HexabitzPlatform/H1FR0x-Hardware/README.md

# H1FR0x-Hardware
Hexabitz Sub-GHz RF Module Hardware Design
