HexabitzPlatform/H1FR0x-Hardware/H1FR50/Released/BOM/H1FR50.xlsx

Qty | Comment | Designator | Description | MFN | MPN | Tolerance | OCTOPART_URL | Qty
4 | PAD1 | B, C, D, R | SMD Pin 1mm x 1.6mm
5 | 100nF | C1, C6, C7, C8, C9 | CAP CER 10% X7R 0603 | KEMET | C0603C104K8RACTU | 10% | https://octopart.com/c0603c103k5ractu-kemet-133094?r=sp&s=R_iPBxLnSmGqhkU2rIMFpg
1 | 100nF | C11 | X7R SMD Chip Capacitor | Murata | GRM155R71C104KA88D | 10% | https://octopart.com/grm155r71c104ka88d-murata-196880?r=sp
2 | 1uF | C2, C17 | Cap Tant Solid SMD 2012 | Yageo | CC0805KKX7R7BB105 | 10% | https://octopart.com/cc0805kkx7r7bb105-yageo-8376555?r=sp&s=YKl1wwtkROau_X5nniH2ig
1 | 2.2uF | C18 | 0805 2.2 uF 16 V ±10% Tolerance X7R Multilayer Ceramic Chip Capacitor | Taiyo Yuden | EMK212B7225KGHT |  | https://octopart.com/emk212b7225kght-taiyo+yuden-29102998?r=sp
2 | 4.7uF | C3, C4 | Cap Tant Solid SMD 2012 | Murata | GRM21BC81E475KA12L |  | https://octopart.com/grm21bc81e475ka12l-murata-10331911?r=sp&s=RY3qZSD8T6mG6TC9CHI5qQ
1 | 10nF | C5 | CAP CER 10% X7R 0603 | KEMET | C0603C103K5RACTU |  | https://octopart.com/c0603c103k5ractu-kemet-133094?r=sp&s=R_iPBxLnSmGqhkU2rIMFpg
1 | 1nF | C16 | 0402 1000 pF 50 V ±10% Tolerance X7R Multilayer Ceramic Chip Capacitor | Murata | GRM155R71H102KA01D | 10% | https://octopart.com/grm155r71h102ka01d-murata-196021?r=sp
1 | 3.9pF | C14 | Multilayer Ceramic Capacitors MLCC - SMD/SMT 0402 3.9pF 50volts C0G +/-0.05pF | Murata | GRM1555C1H3R9WA01D |  | https://octopart.com/grm1555c1h3r9wa01d-murata-20477997?r=sp
1 | 56pF | C12 | 0402 56 pF 50 V ±5 % Tolerance C0G SMT Multilayer Ceramic Capacitor | Murata | GRM1555C1H560JA01D |  | https://octopart.com/grm1555c1h560ja01d-murata-15197568?r=sp
1 | 100pF | C10 | 0402 100pF 50V ±5 % Tolerance C0G SMT Multilayer Ceramic Capacitor | Murata | GRM1555C1H101JA01D |  | https://octopart.com/grm1555c1h101ja01d-murata-15197512?r=sp
2 | 120pF | C13, C15 | 0402 120 pF 50 V ±5% Tolerance C0G SMT Multilayer Ceramic Capacitor | Murata | GRM1555C1H121JA01D |  | https://octopart.com/grm1555c1h121ja01d-murata-196010?r=sp
1 | VLMS1300-GS08 | D1 | Red 0603 130ｰ Clear 54 mcd 2 V Surface Mount ChipLED ; | Vishay | VLMS1300-GS08 |  | https://octopart.com/vlms1300-gs08-vishay-21709201?r=sp&s=_gcP4_q8T1SC6PJQPTQ9yA
1 | ESDARF02-1BU2CK | D2 | ESDARF Series 5 V 0.2 pF Bi-Directional 1-Line ESD Protection TVS Diode - ST0201 | STMicroelectronics | ESDARF02-1BU2CK |  | https://octopart.com/esdarf02-1bu2ck-stmicroelectronics-57390019?r=sp
1 | FB-TDK_MMZ1608Y300B | FB1 | Ferrite Beads Multi-Layer 30Ohm 25% 100MHz 1.5A 50mOhm DCR 0603 | TDK | MMZ1608Y300B |  | https://octopart.com/mmz1608y300b-tdk-368280?r=sp&s=cd9_2ZEqQ9q9UNBuQgHAiA
1 | LQW15AN6N8G00D | FB2 | Inductor RF Chip Wirewound 6.8nH 2% 100MHz 25Q-Factor 700mA 90mOhm DCR 0402 Paper T/R | Murata | LQW15AN6N8G00D |  | https://octopart.com/lqw15an6n8g00d-murata-7896134?r=sp
1 | 744784156A | FB3 | Fixed Ind 56NH 200MA 1.6 Ohm SMD | Würth Elektronik | 744784156A |  | https://octopart.com/744784156a-w%C3%BCrth+elektronik-46756303?r=sp
1 | 0.0R | R3 | Thick Film Resistors - SMD 0603 | Yageo | RC0603JR-0710KL | ±5% | https://octopart.com/search?q=RC0603JR-0710KL&start=0
3 | 0.0R | R4, R10, R12 | Thick Film Resistors - SMD 0403 | Yageo | AC0402FR-070RL | ±1% | https://octopart.com/ac0402fr-070rl-yageo-24501937?r=sp
6 | 0.0R NM | R6, R7, R8, R9, R11, R13 | Thick Film Resistors - SMD 0403 | Yageo | AC0402FR-070RL | ±1% | https://octopart.com/ac0402fr-070rl-yageo-24501937?r=sp
1 | 3.0R | R14 | Thick Film Resistors - SMD 0403 | Yageo | AC0402FR-073RL | ±1% | https://octopart.com/ac0402fr-073rl-yageo-71366773?r=sp
1 | 270.0R | R1 | Thick Film Resistors - SMD 0603 | Yageo | RC0603FR-07270RL | ±5% | https://octopart.com/search?q=RC0603FR-07270RL&start=0
1 | 10.0K | R2 | Thick Film Resistors - SMD 0603 | Yageo | RC0603JR-070RL |  | https://octopart.com/rc0603jr-070rl-yageo-1241539?r=sp&s=X2NteqRjRNWrnx42Y0aliA
1 | 10.0K | R5 | Thick Film Resistors - SMD 0403 | TE Connectivity | CRGCQ0402F10K | ±1% | https://octopart.com/crgcq0402f10k-te+connectivity-91017932?r=sp
1 | 734120110 | P2 | Conn; RF/Coaxial; SMT; 50 Ohms; 1.25mm; Straight; Jack; Gold Plated | Molex | 734120110 |  | https://octopart.com/0734120110-molex-16756629?r=sp&s=MrVch9BMTneaw8n1KM-Tpw
1 | STM32F091CBU6 | U1 | IC MCU 32BIT 128KB FLASH 48QFPN | STMicroelectronics | STM32F091CBU6 |  | https://octopart.com/stm32f091cbu6-stmicroelectronics-51988677?r=sp&s=bU6fpgsrTZOxHyt7jkfh3w
1 | TPS22943DCKR | U2 | 5.5-V, 0.04-A, 500-mΩ, load switch with current limit and active high enable 5-SC70 -40 to 85 | Texas Instruments | TPS22943DCKR |  | https://octopart.com/tps22943dckr-texas+instruments-12189794?r=sp
1 | BGA824N6E6327XTSA1 | U3 | GPS Amp Single Low Noise Amplifier 1615MHz 3.3V 6-Pin TSNP T/R | Infineon | BGA824N6E6327XTSA1 |  | https://octopart.com/bga824n6e6327xtsa1-infineon-33343805?r=sp
1 | TESEO-LIV3F | U4 | - RF Receiver BeiDou, Galileo, GLONASS, GNSS, GPS 1.575GHz -163dBm 18-LCC (9.7x10.1) | STMicroelectronics | TESEO-LIV3F |  | https://octopart.com/teseo-liv3f-stmicroelectronics-84762432?r=sp
1 | B39162B4327P810 | U5 | Low-loss RF GPS + COMPASS + Galileo + GLONASS filter 1582.4 MHz | RF360 Holdings | B39162B4327P810 |  | https://octopart.com/b39162b4327p810-rf360+holdings-78742154?r=sp
1 | XTALL_CSTCE8M00G52 | X1 | MURATA CSTCE8M00G52-R0 RESONATOR, SMD, 8MHZ ; | Murata | CSTCE8M00G52Z-R0 |  | https://octopart.com/cstce8m00g52z-r0-murata-17755941?r=sp&s=JDnNJnrHQhyS8Zk4ofFWXw
