HexabitzPlatform/H1FR0x-Hardware/H1FR00/Released/BOM/H1FR0.xlsx

Qty | Comment | Designator | Description | MFN | MPN | OCTOPART_URL
4 | PAD1 | B, C, D, R | SMD Pad
5 | 100nF | C1, C6, C7, C8, C9 | CAP CER 10% X7R 0603 | KEMET | C0603C104K8RACTU | https://octopart.com/c0603c104k8ractu-kemet-145075?r=sp&s=9bS9ASSwSEqMCE9KBEQZ0g
1 | 1.00uF | C2 | Cap Tant Solid SMD 2012 | Yageo | CC0805KKX7R7BB105 | https://octopart.com/cc0805kkx7r7bb105-yageo-8376555?r=sp&s=YKl1wwtkROau_X5nniH2ig
2 | 4.7uF | C3, C4 | Cap Tant Solid SMD 2012 | Murata | GRM21BC81E475KA12L | https://octopart.com/grm21bc81e475ka12l-murata-10331911?r=sp&s=RY3qZSD8T6mG6TC9CHI5qQ
1 | 10nF | C5 | CAP CER 10% X7R 0603 | KEMET | C0603C103K5RACTU | https://octopart.com/c0603c103k5ractu-kemet-133094?r=sp&s=R_iPBxLnSmGqhkU2rIMFpg
7 | 100nF | C10, C11, C12, C13, C15, C16, C18 | CAP CER 10% 0402 | Murata | GRM155R70J104KA01D | https://octopart.com/grm155r70j104ka01d-murata-17930200
2 | 22uF | C14, C17 | CAP CER 22UF 6.3V X5R 0805 | Yageo | CC0805KKX5R5BB226 (https://octopart.com/cc0805kkx5r5bb226-yageo-25629575?r=sp&s=DJMYXR2VSIGpyeFvsGQHkQ) | https://octopart.com/search?q=CC0805KKX5R5BB226&start=0
1 | 1uF | C19 | CAP CER 10% X7R 0603 | Murata | GRM188R70J105KA01D | https://octopart.com/grm188r70j105ka01d-murata-197450
2 | 3.6pF | C20, C21 | CAP CER 10% 0402 | Murata | GRM1555C1H3R6CA01D | https://octopart.com/grm1555c1h3r6ca01d-murata-18814425
2 | 100pF | C22, C29 | CAP CER 10% 0402 | Murata | GRM1555C1H101JA01D | https://octopart.com/grm1555c1h101ja01d-murata-15197512
1 | 2.7pF | C23 | CAP CER 10% 0402 | Murata | GRM1555C1H2R7CA01D | https://octopart.com/search?q=GRM1555C1H2R7CA01D&start=0
1 | 6.2pF | C24 | CAP CER 10% 0402 | Murata | GRM1555C1H6R2CA01D | https://octopart.com/search?q=GRM1555C1H6R2CA01D&start=0
1 | 3.0pF | C25 | CAP CER 10% 0402 | Murata | GRM1555C1H3R0CA01D | https://octopart.com/search?q=GRM1555C1H3R0CA01D&start=0
2 | 12pF | C27, C28 | CAP CER 10% X7R 0603 | AVX | 06035A120JAT2A | https://octopart.com/06035a120jat2a-avx-194785
1 | VLMS1300-GS08 | D1 | Red 0603 130° Clear 54 mcd 2 V Surface Mount ChipLED ; | Vishay | VLMS1300-GS08 | https://octopart.com/vlms1300-gs08-vishay-21709201?r=sp&s=_gcP4_q8T1SC6PJQPTQ9yA
1 | FB-TDK_MMZ1608Y300B | FB1 | Ferrite Beads Multi-Layer 30Ohm 25% 100MHz 1.5A 50mOhm DCR 0603 | TDK | MMZ1608Y300B | https://octopart.com/mmz1608y300b-tdk-368280?r=sp&s=cd9_2ZEqQ9q9UNBuQgHAiA
1 | 10.0uH | FB2 | Ferrite Beads Multi-Layer 0805 | Taiyo Yuden | CKS2125100M-T | http://octopart.com/cks2125100m-t-taiyo+yuden-18605517
2 | 7.5nH | L1, L6 | Inductor - SMD 0402 | Murata | LQG15HS7N5J02D | https://octopart.com/search?q=LQG15HS7N5J02D&start=0
1 | 27nH | L2 | Inductor - SMD 0402 | Murata | LQG15HS27NJ02D | https://octopart.com/search?q=LQG15HS27NJ02D&start=0
2 | 6.80nH | L4, L5 | Inductor - SMD 0402 | Murata | LQW15AN6N8G00D | https://octopart.com/lqw15an6n8g00d-murata-7896134
1 | SMA Jack | P1 | CONN SMA JACK R/A 50 OHM PCB | TE Connectivity | 5-1814400-1 | https://octopart.com/search?q=5-1814400-1&oq=5-1814400-1&start=0
1 | HEXABIT_17.32_NO_P4 | P2 | HEXABIT CONNECTOR
1 | 270.0R | R1 | Thick Film Resistors - SMD 0603 | Yageo | RC0603FR-07270RL | https://octopart.com/search?q=RC0603FR-07270RL&start=0
2 | 10.0K | R2, R7 | Thick Film Resistors - SMD 0603 | Yageo | RC0603JR-0710KL | https://octopart.com/search?q=RC0603JR-0710KL&start=0
1 | 0.0R | R3 | Thick Film Resistors - SMD 0603 | Yageo | RC0603JR-070RL | https://octopart.com/rc0603jr-070rl-yageo-1241539?r=sp&s=X2NteqRjRNWrnx42Y0aliA
1 | STM32F091CBU6 | U1 | MCU 32-bit ARM Cortex M0 RISC 128KB Flash 2.5V/3.3V 48-Pin UFQFPN | STMicroelectronics | STM32F091CBU6 | https://octopart.com/stm32f091cbu6-stmicroelectronics-51988677?r=sp&s=bU6fpgsrTZOxHyt7jkfh3w
1 | CC1310F128RHBT | U2 | Sub-1 GHz Ultra-Low Power Wireless Microcontroller 32-VQFN | Texas Instruments | CC1310F128RHBT | http://octopart.com/cc1310f128rhbt-texas+instruments-65758956
1 | XTALL_CSTCE8M00G52 | X1 | MURATA CSTCE8M00G52-R0 RESONATOR, SMD, 8MHZ ; | Murata | CSTCE8M00G52Z-R0 | https://octopart.com/cstce8m00g52z-r0-murata-17755941?r=sp&s=JDnNJnrHQhyS8Zk4ofFWXw
1 | 32.768 KHz | X2 | CRYSTAL 32.7680KHZ 12.5PF SMD | EPSON | FC-12M 32.7680KA-A3 | https://octopart.com/fc-12m+32.7680ka-a3-epson-44407702
1 | 24.0 MHz | X3 | TSX-3225 Series 24 MHz ±10 ppm 9 pF -40 to +105°C Surface Mount Crystal Unit | EPSON | TSX-3225 24.0000MF20G-AC3 | https://octopart.com/tsx-3225+24.0000mf20g-ac3-epson-44407675
