HexabitzPlatform/H1FR0x-Hardware/H1FR50/Documentation/H1FR50.pdf

# PA0 PA1 PA2 PA3 PA4 PA5 PA6 PA7 PA8 PA9 PA10 PA11 PA12 PA13 PA14 PA15 PC13 PC15-OSC32_OUT

# PB0 PB1 PB2 PB3 PB4 PB5 PB6 PB7 PB8 PB9 PB10 PB11 PB12 PB13 PB14 PB15 PF0-OSC_IN

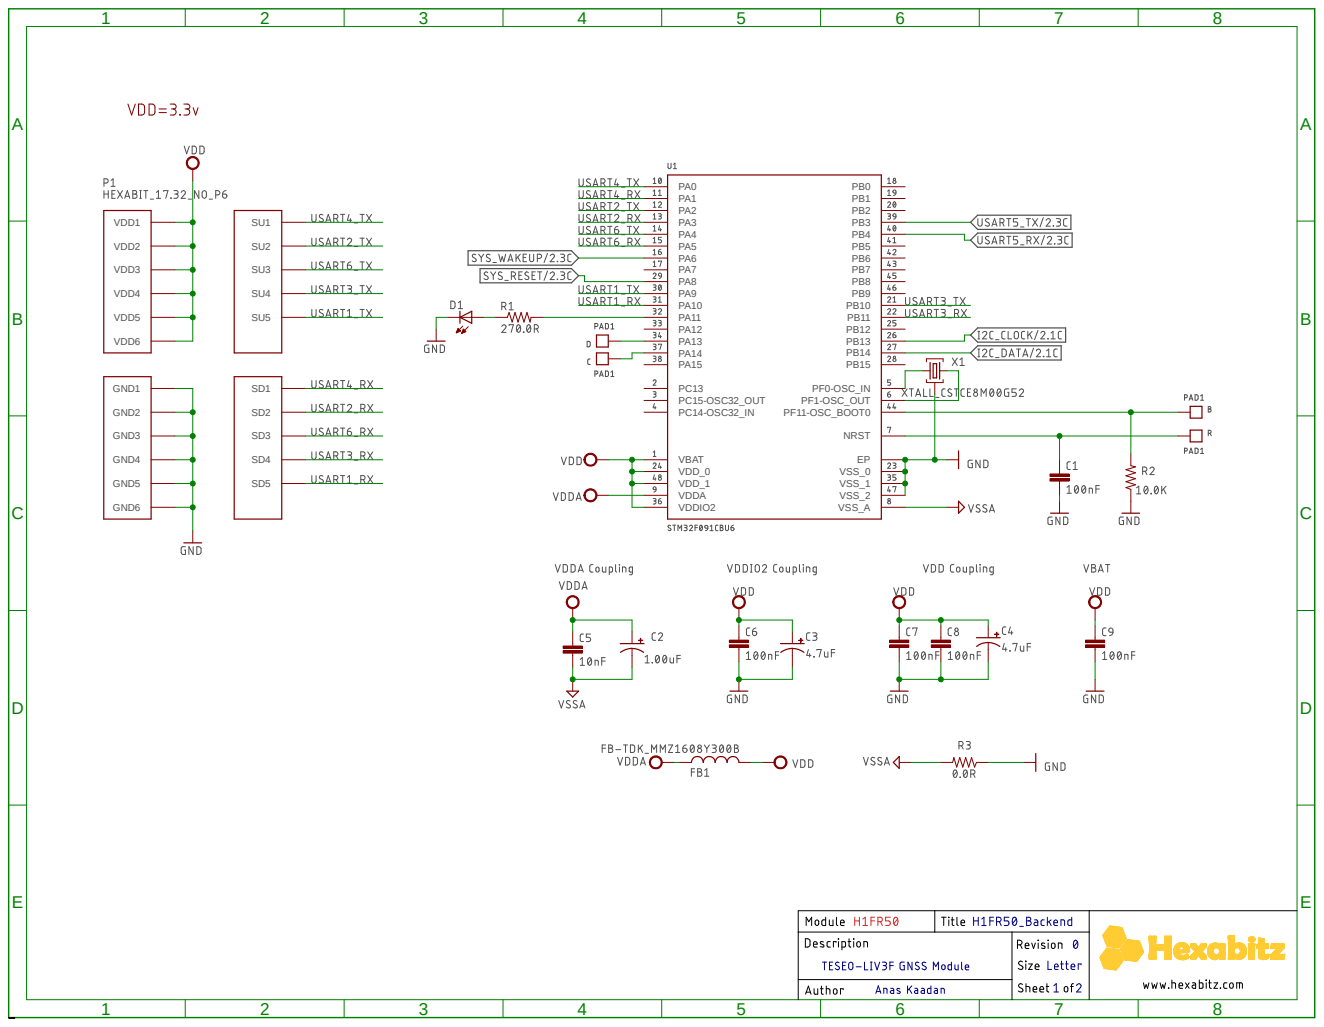
[picture p1: page 1]
PC14-OSC32_IN; VBAT VDD_0; VDD_1 VDDA; VDDIO2; PF1-OSC_OUT PF11-OSC_BOOT0 NRSTEP; VSS_0 VSS_1 VSS_2 VSS_A; VDD1 VDD2 VDD3 VDD4 VDD5 VDD6 GND1 GND2 GND3 GND4 GND5 GND6

A

A

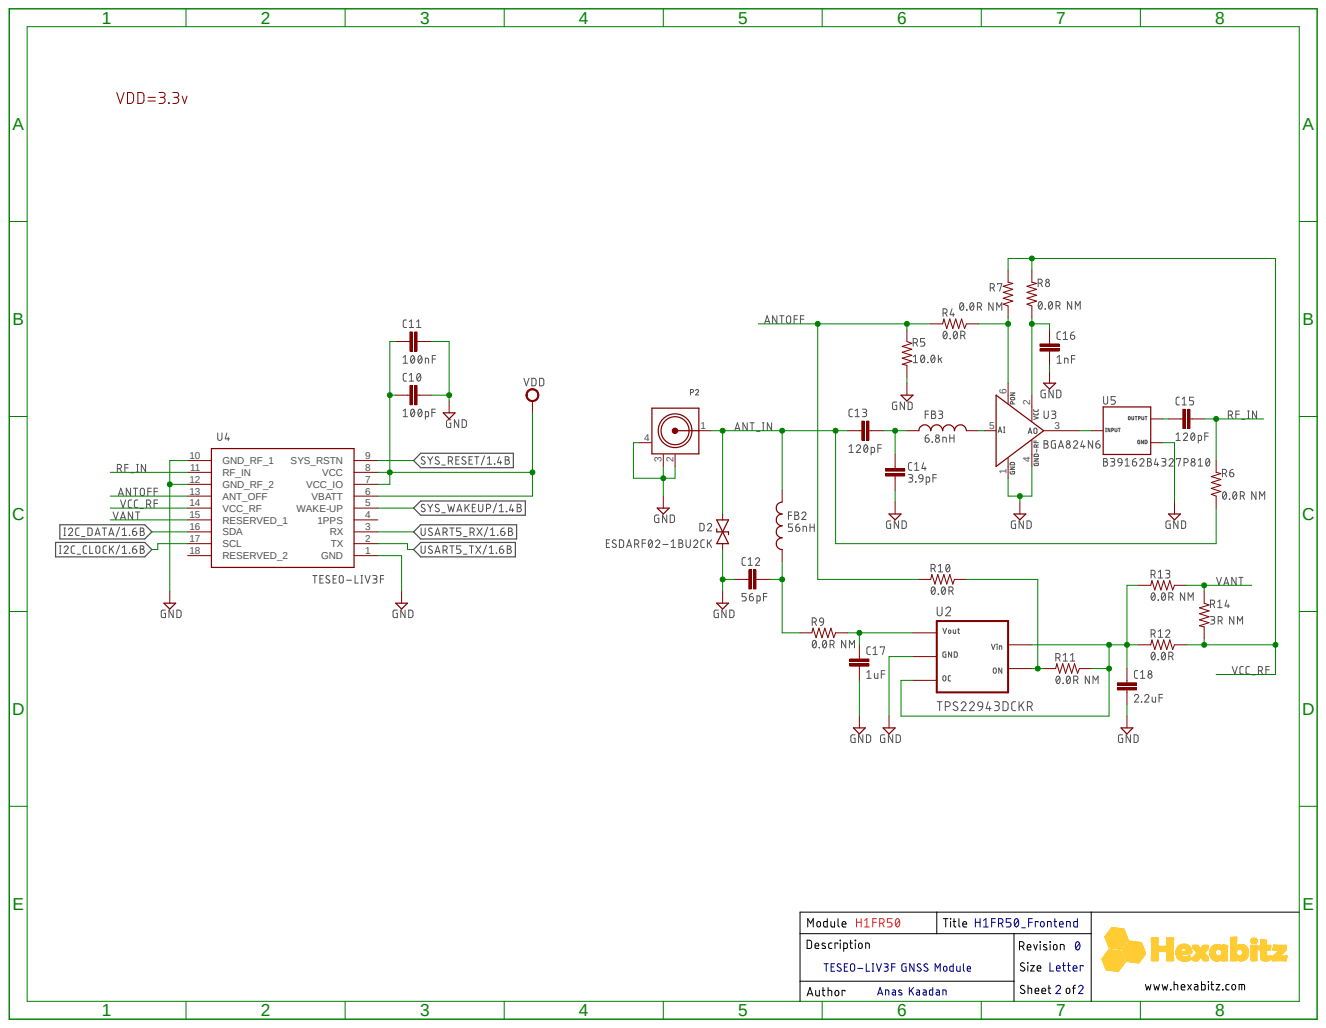
[picture p2: page 2]
GND; 1PPS; 4 WAKE-UP; 5 VBATT; 6 VCC_IO; 7 VCC; 8 SYS_RSTN; 9 RESERVED_2 18; SCL 17; SDA 16; RESERVED_1 15; VCC_RF 14; ANT_OFF 13; GND_RF_2 12; GND_RF_1 10
