HexabitzPlatform/H1FR0x-Hardware/H1FR00/Documentation/H1FR0.pdf

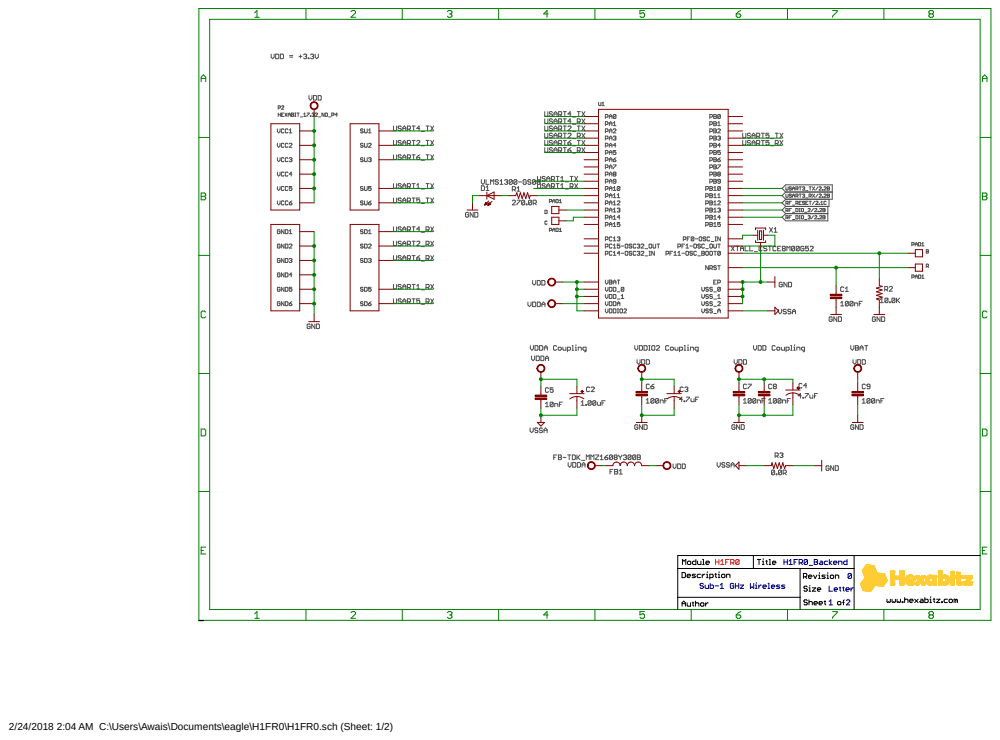
[picture p3: page 1]

2/24/2018 2:04 AM C:\Users\Awais\Documents\eagle\H1FR0\H1FR0.sch (Sheet: 1/2)

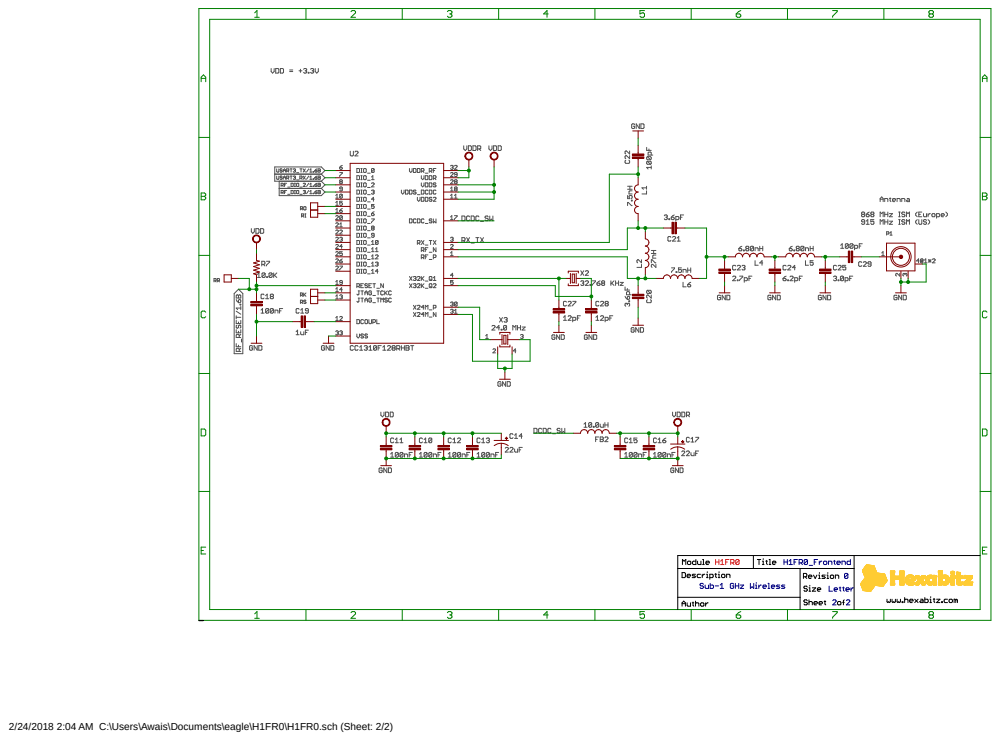
[picture p4: page 2]

2/24/2018 2:04 AM C:\Users\Awais\Documents\eagle\H1FR0\H1FR0.sch (Sheet: 2/2)
