HexabitzPlatform/H1FR0x-Hardware/H1FR00/Design/H1FR0.brd

## EAGLE design H1FR00/Design/H1FR0.brd (2019-05-23)

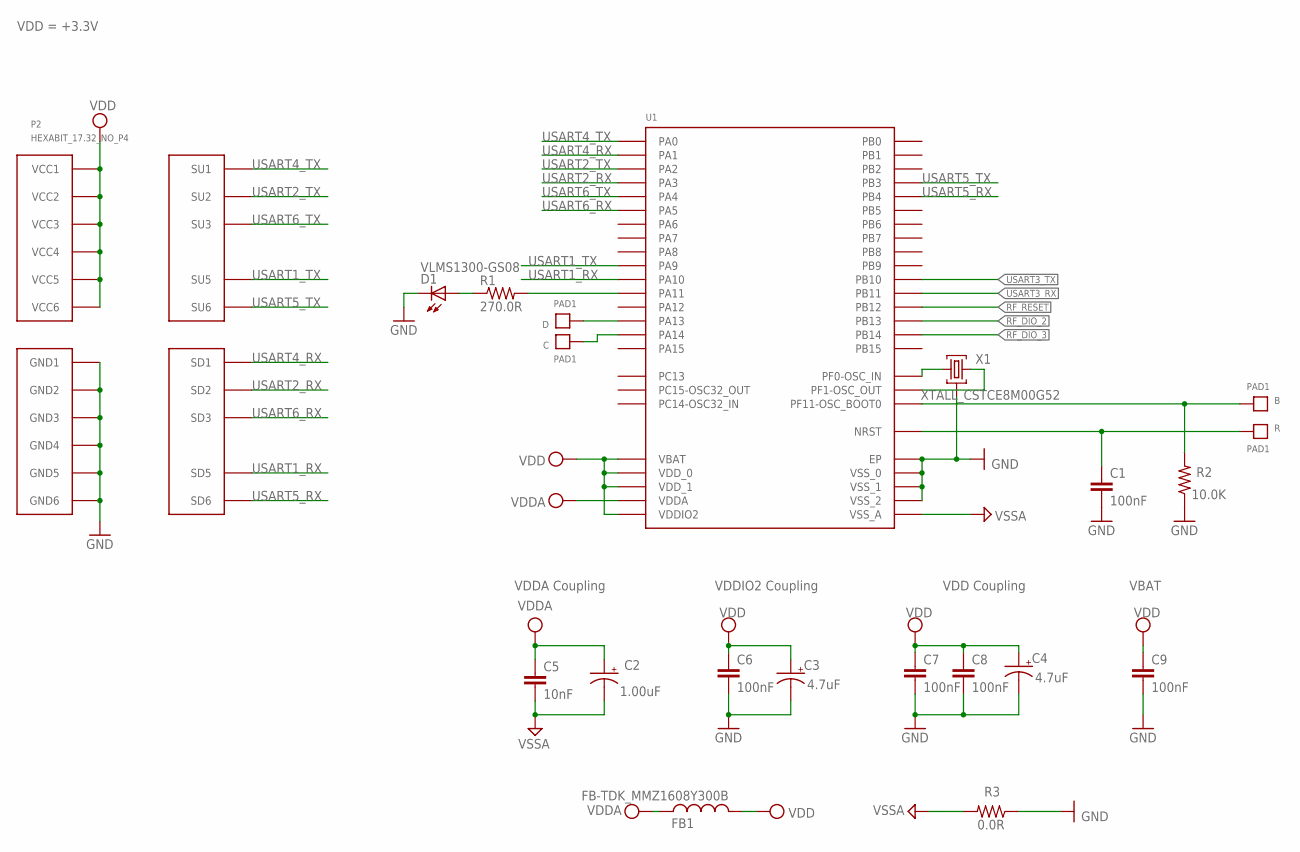
[picture p5: schematic H1FR0.sch, sheet 1]

Parts:
B: PAD1
C: PAD1
C1, C6, C8: 100nF; C-0603; TOLERANCE 10%; VOLTAGE_RATING 10V; MPN C0603C104K8RACTU
C2: 1.00uF; C-0805; TOLERANCE 10%; VOLTAGE_RATING 16V; MPN CC0805KKX7R7BB105
C3, C4: 4.7uF; C-0805; TOLERANCE 10%; VOLTAGE_RATING 25V; MPN GRM21BC81E475KA12L
C5: 10nF; C-0603; TOLERANCE 10%; VOLTAGE_RATING 50V; MPN C0603C103K5RACTU
C7: 100nF; C-0603; TOLERANCE 10%; VOLTAGE_RATING 10; MPN C0603C104K8RACTU
C9: 100nF; C-0603; TOLERANCE 10V; VOLTAGE_RATING 10%; MPN C0603C104K8RACTU
D: PAD1
D1: VLMS1300-GS08; MPN VLMS1300-GS08
FB1: FB-TDK_MMZ1608Y300B; MPN MMZ1608Y300B
P2: HEXABIT_17.32_NO_P4
R: PAD1
R1: 270.0R; R-0603; TOLERANCE 1%; MPN RC0603FR-07270RL
R2: 10.0K; R-0603; TOLERANCE 5%; MPN RC0603JR-0710KL
R3: 0.0R; R-0603; MPN RC0603JR-070RL
U1: STM32F091CBU6
X1: XTALL_CSTCE8M00G52

Connections:
B: B.P$1, B.P$2, R2.2, U1.P$44 (PF11-OSC_BOOT0)
GND: C1.2, C3.2 (-), C4.2 (-), C6.2, C7.2, C8.2, C9.2, D1.C, P2.7 (GND1), P2.8 (GND2), P2.9 (GND3), P2.10 (GND4), P2.11 (GND5), P2.12 (GND6), R2.1, R3.1, U1.EP, U1.P$23 (VSS_0), U1.P$35 (VSS_1), U1.P$47 (VSS_2), X1.P$2 (2); also elsewhere on the board
unnamed: D.P$1, D.P$2, U1.P$34 (PA13)
unnamed: C.P$1, C.P$2, U1.P$37 (PA14)
unnamed: R1.2, U1.P$32 (PA11)
unnamed: D1.A, R1.1
unnamed: U1.P$5 (PF0-OSC_IN), X1.P$1 (1)
unnamed: U1.P$6 (PF1-OSC_OUT), X1.P$3 (3)
R: C1.1, R.P$1, R.P$2, U1.P$7 (NRST)
RF_DIO_2: U1.P$26 (PB13); also elsewhere on the board
RF_DIO_3: U1.P$27 (PB14); also elsewhere on the board
RF_RESET: U1.P$25 (PB12); also elsewhere on the board
USART1_RX: P2.23 (SD5), U1.P$31 (PA10)
USART1_TX: P2.17 (SU5), U1.P$30 (PA9)
USART2_RX: P2.20 (SD2), U1.P$13 (PA3)
USART2_TX: P2.14 (SU2), U1.P$12 (PA2)
USART3_RX: U1.P$22 (PB11); also elsewhere on the board
USART3_TX: U1.P$21 (PB10); also elsewhere on the board
USART4_RX: P2.19 (SD1), U1.P$11 (PA1)
USART4_TX: P2.13 (SU1), U1.P$10 (PA0)
USART5_RX: P2.25 (SD6), U1.P$40 (PB4)
USART5_TX: P2.18 (SU6), U1.P$39 (PB3)
USART6_RX: P2.21 (SD3), U1.P$15 (PA5)
USART6_TX: P2.15 (SU3), U1.P$14 (PA4)
VDD: C3.1 (+), C4.1 (+), C6.1, C7.1, C8.1, C9.1, FB1.2, P2.1 (VCC1), P2.2 (VCC2), P2.3 (VCC3), P2.4 (VCC4), P2.5 (VCC5), P2.6 (VCC6), U1.P$1 (VBAT), U1.P$24 (VDD_0), U1.P$36 (VDDIO2), U1.P$48 (VDD_1); also elsewhere on the board
VDDA: C2.1 (+), C5.1, FB1.1, U1.P$9 (VDDA)
VSSA: C2.2 (-), C5.2, R3.2, U1.P$8 (VSS_A)

Notes on the sheet:
VDDA Coupling
VDDIO2 Coupling
VDD Coupling
VBAT
VDD = +3.3V

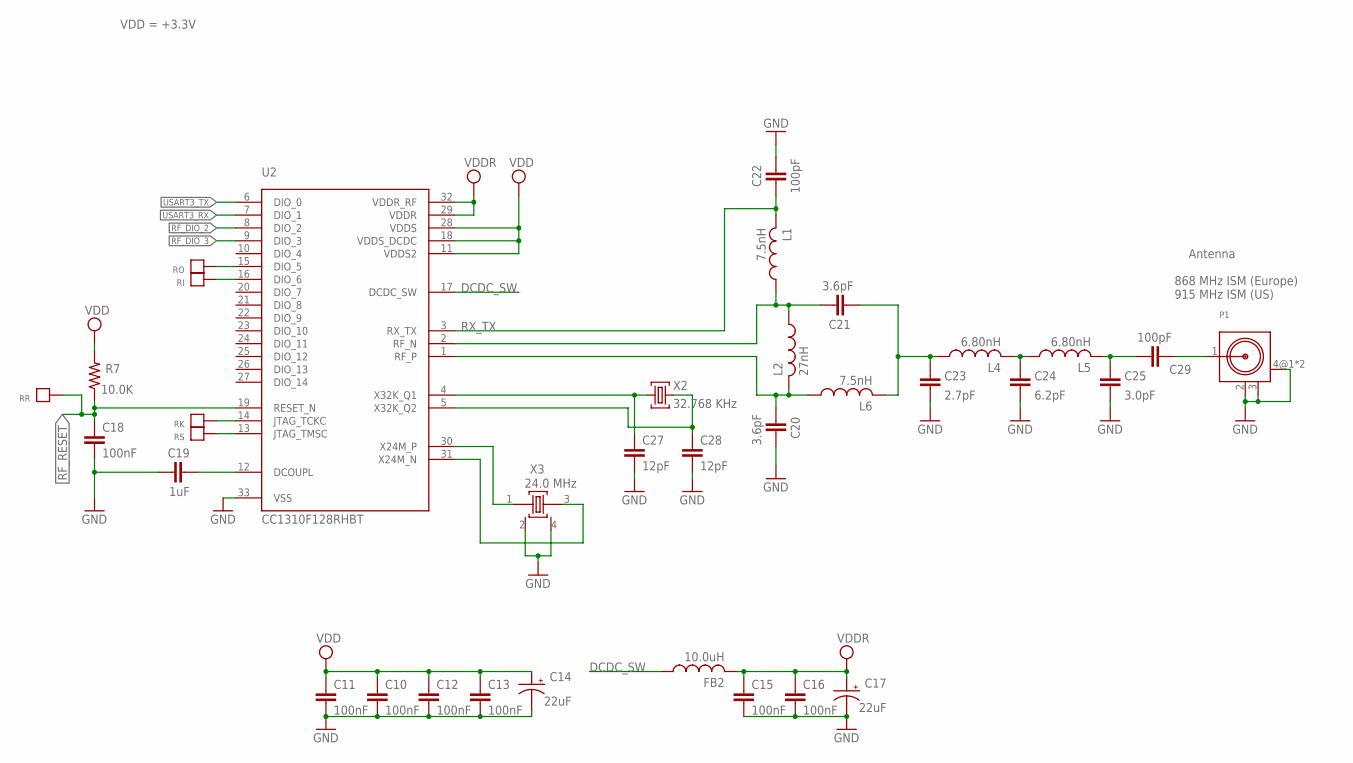
[picture p6: schematic H1FR0.sch, sheet 2]

Parts:
C10, C11, C12, C13, C15, C16, C18: 100nF; C-0402; TOLERANCE ±10%; VOLTAGE_RATING 6.3 V; MPN GRM155R70J104KA01D
C14, C17: 22uF; C-0805; TOLERANCE 10%; VOLTAGE_RATING 6.3V; MPN CC0805KKX5R5BB226
C19: 1uF; C-0603; TOLERANCE 10%; VOLTAGE_RATING 6.3V; MPN GRM188R70J105KA01D
C20: 3.6pF; C-0402; TOLERANCE ±0.25pF; VOLTAGE_RATING 50 V; MPN GRM1555C1H3R6CA01D
C21: 3.6pF; C-0402; TOLERANCE ±0.25%; VOLTAGE_RATING 50 V; MPN GRM1555C1H3R6CA01D
C22, C29: 100pF; C-0402; TOLERANCE ±5%; VOLTAGE_RATING 50V; MPN GRM1555C1H101JA01D
C23: 2.7pF; C-0402; TOLERANCE ±0.25 pF; VOLTAGE_RATING 50 V; MPN GRM1555C1H2R7CA01D
C24: 6.2pF; C-0402; TOLERANCE ±0.25pF; VOLTAGE_RATING 50 V; MPN GRM1555C1H6R2CA01D
C25: 3.0pF; C-0402; TOLERANCE ±0.25 pF; VOLTAGE_RATING 50 V; MPN GRM1555C1H3R0CA01D
C27, C28: 12pF; C-0603; TOLERANCE 5%; VOLTAGE_RATING 50V; MPN 06035A120JAT2A
FB2: 10.0uH; FB-0805; MPN CKS2125100M-T
L1, L6: 7.5nH; IND-0402; MPN LQG15HS7N5J02D
L2: 27nH; IND-0402; MPN LQG15HS27NJ02D
L4, L5: 6.80nH; IND-0402; MPN LQW15AN6N8G00D
P1: 5-1814400-1
R7: 10.0K; R-0603; TOLERANCE 5%; MPN RC0603JR-0710KL
RI: PAD4
RK: PAD4
RO: PAD4
RR: PAD4
RS: PAD4
U2: CC1310F128RHBT
X2: 32.768 KHz; XTALL_FC-12M
X3: 24.0 MHz; XTALL_TXS-3225-24.0000M

Connections:
DCDC_SW: FB2.1, U2.17 (DCDC_SW)
GND: C10.2, C11.2, C12.2, C13.2, C14.2 (-), C15.2, C16.2, C17.2 (-), C18.2, C19.1, C20.2, C22.2, C23.1, C24.1, C25.1, C27.2, C28.2, P1.2, P1.3, P1.4@1 (4), P1.4@2 (4), U2.33 (VSS), X3.2, X3.4; also elsewhere on the board
unnamed: RO.P$1, U2.15 (DIO_5)
unnamed: C21.1, C23.2, L4.1, L6.2
unnamed: C19.2, U2.12 (DCOUPL)
unnamed: RK.P$1, U2.14 (JTAG_TCKC)
unnamed: RS.P$1, U2.13 (JTAG_TMSC)
unnamed: C24.2, L4.2, L5.1
unnamed: C25.2, C29.2, L5.2
unnamed: C29.1, P1.1
unnamed: C27.1, U2.4 (X32K_Q1), X2.P$2 (2)
unnamed: C28.1, U2.5 (X32K_Q2), X2.P$1 (1)
unnamed: U2.30 (X24M_P), X3.1
unnamed: U2.31 (X24M_N), X3.3
unnamed: RI.P$1, U2.16 (DIO_6)
unnamed: C21.2, L1.1, L2.1, U2.2 (RF_N)
unnamed: C20.1, L2.2, L6.1, U2.1 (RF_P)
RF_DIO_2: U2.8 (DIO_2); also elsewhere on the board
RF_DIO_3: U2.9 (DIO_3); also elsewhere on the board
RF_RESET: C18.1, R7.1, RR.P$1, U2.19 (RESET_N); also elsewhere on the board
RX_TX: C22.1, L1.2, U2.3 (RX_TX)
USART3_RX: U2.7 (DIO_1); also elsewhere on the board
USART3_TX: U2.6 (DIO_0); also elsewhere on the board
VDD: C10.1, C11.1, C12.1, C13.1, C14.1 (+), R7.2, U2.11 (VDDS2), U2.18 (VDDS_DCDC), U2.28 (VDDS); also elsewhere on the board
VPP: C15.1, C16.1, C17.1 (+), FB2.2, U2.29 (VDDR), U2.32 (VDDR_RF)

Notes on the sheet:
VDD = +3.3V
Antenna 868 MHz ISM (Europe) 915 MHz ISM (US)

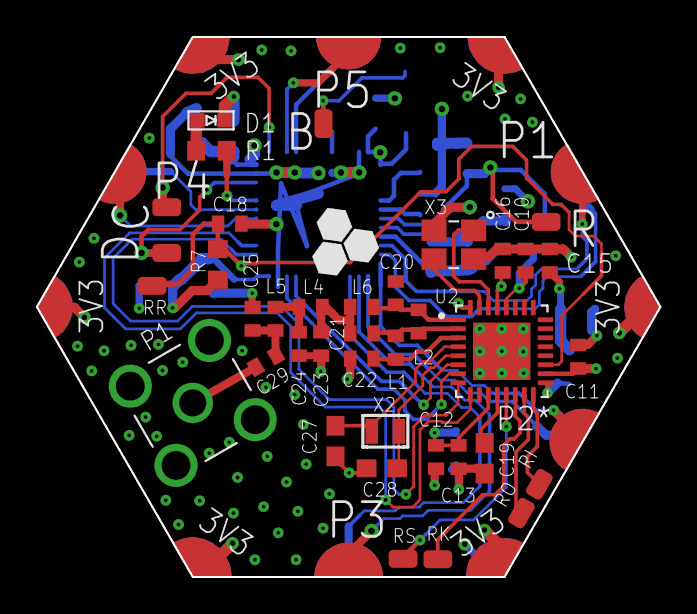
[picture p7: board H1FR0.brd from above]

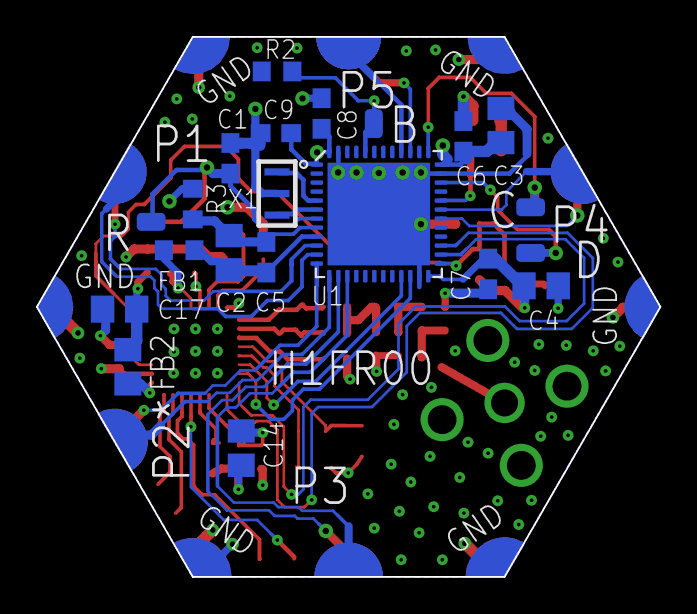
[picture p8: board H1FR0.brd from below]

Board: 4 copper layers, 34.6 x 30.0 mm, 56 parts (17 on the bottom side), 45 nets.
