HexabitzPlatform/H1FR0x-Hardware/(commit log)

2019-05-23 First release rev 0
    [H1FR0.brd, H1FR0.sch, H1FR0.xlsx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]
2021-03-17 - Schematic - PCB - BOM
    [H1FR50.brd, H1FR50.sch, H1FR50.xlsx]
2021-03-18 Added Keepout areas in PCB..
    [H1FR50.brd, H1FR50.sch, H1FR50.xlsx]
